BbIKTOP/M.2-key-M-to-wifi/copper_bottom_1200dpi.png

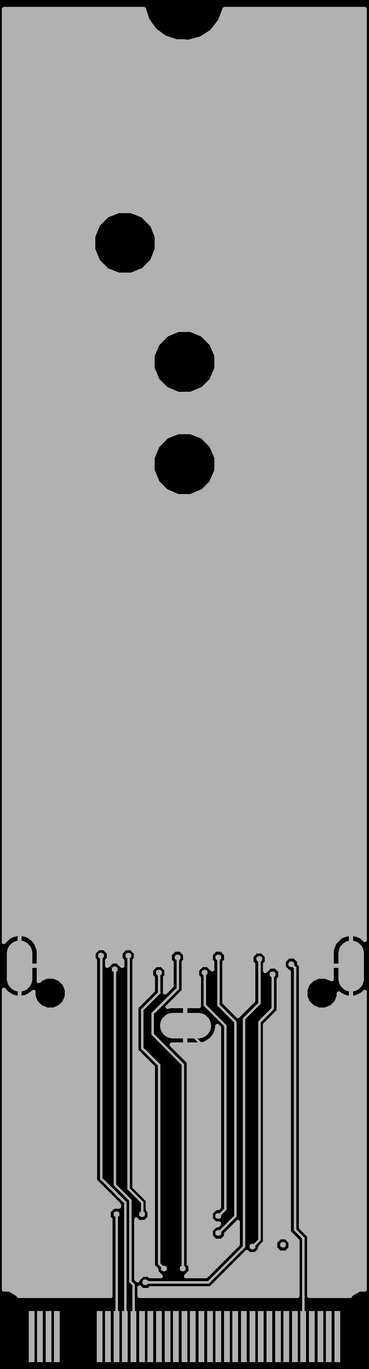
copper_bottom_1200dpi.png
