BbIKTOP/M.2-key-M-to-wifi/copper_top_1200dpi.png

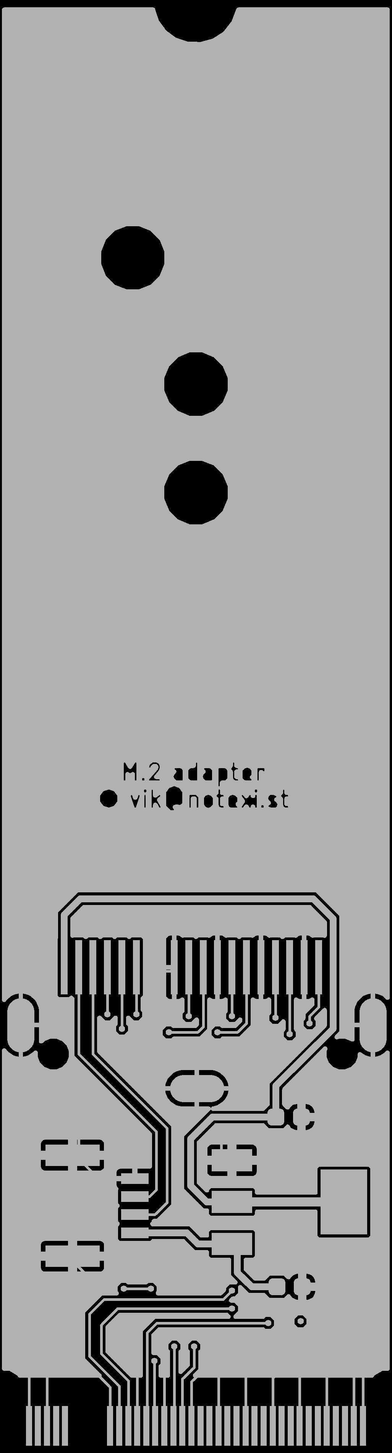
copper_top_1200dpi.png
