BbIKTOP/M.2-key-M-to-wifi/pics/wifi1.png

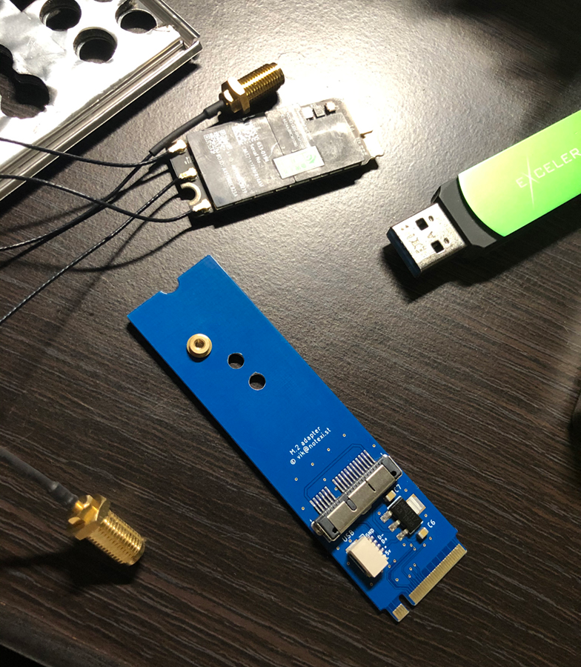
pics/wifi1.png
