BbIKTOP/M.2-key-M-to-wifi/pics/wifi2.png

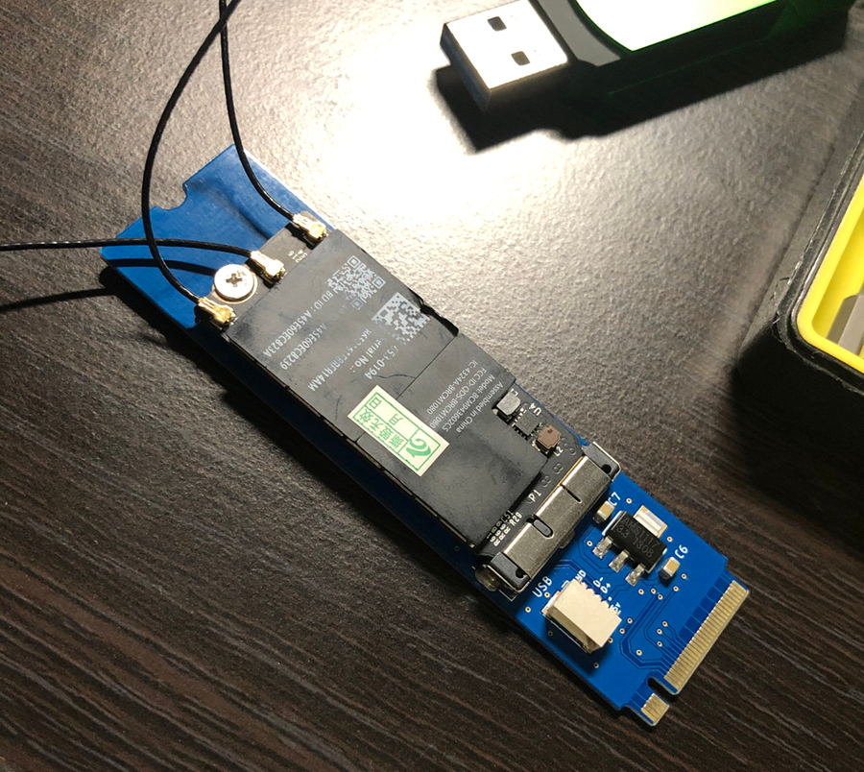
pics/wifi2.png
