BbIKTOP/M.2-key-M-to-wifi/pics/wifi3.png

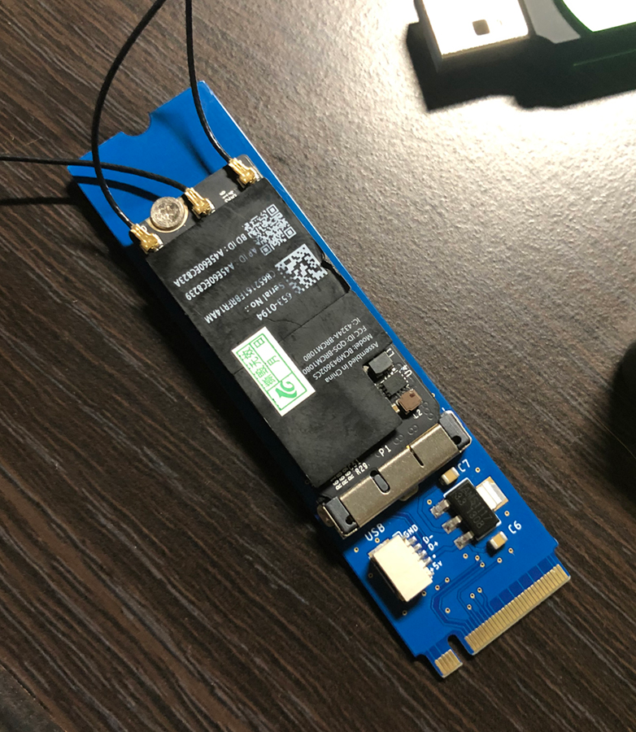
pics/wifi3.png
