BbIKTOP/M.2-key-M-to-wifi/pics/wifi4.png

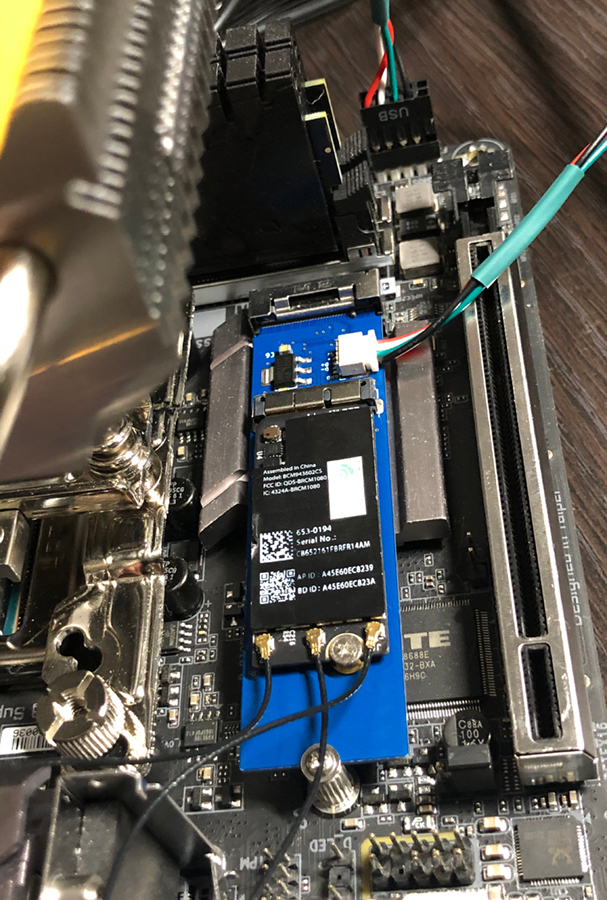
pics/wifi4.png
