BbIKTOP/M.2-key-M-to-wifi/m2_to_apple.sch

## EAGLE design m2_to_apple.sch (2020-07-29)

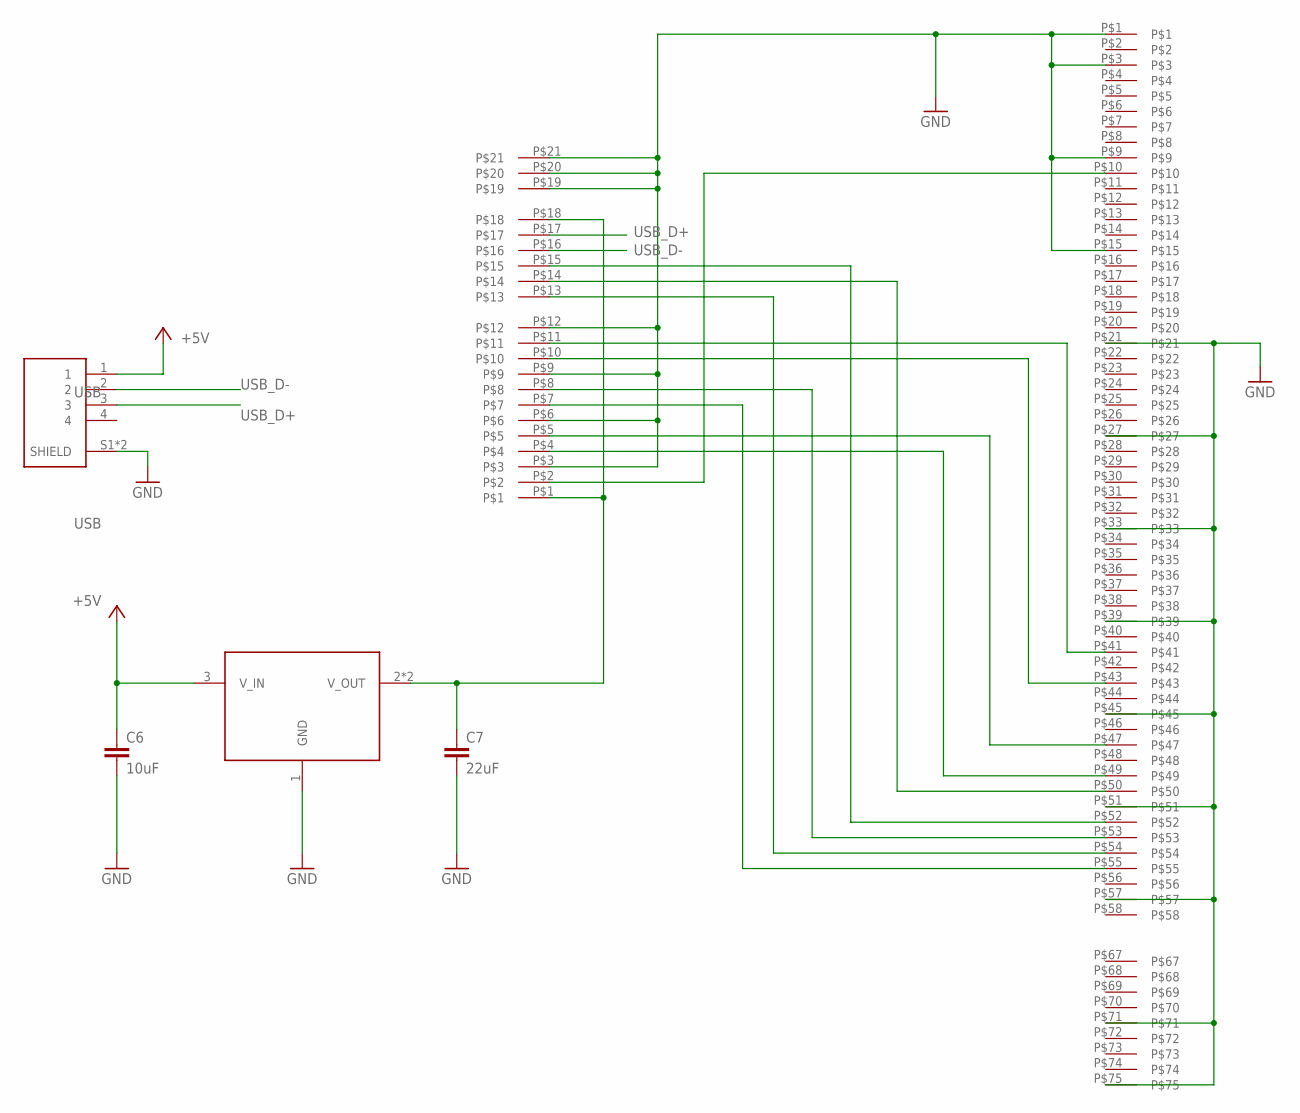
[picture p8: schematic m2_to_apple.sch]

Parts:
C6: 10uF; CAP_0603
C7: 22uF; CAP_0603
U$1: APPLE-WIFI; APPLE_WIFI
U$2: M.2_KEY_MSMD; M.2_KEY_M
U$3: LM1117; SOT223
USB: USB; JST_1MM_4PINS

Connections:
3V3: C7.1, U$1.P$1, U$1.P$18, U$3.2 (V_OUT)
+5V: C6.1, U$3.3 (V_IN), USB.1
CLKREQ#: U$1.P$15, U$2.P$52
GND: C6.2, C7.2, U$1.P$3, U$1.P$6, U$1.P$9, U$1.P$12, U$1.P$19, U$1.P$20, U$1.P$21, U$2.P$1, U$2.P$3, U$2.P$9, U$2.P$15, U$2.P$21, U$2.P$27, U$2.P$33, U$2.P$39, U$2.P$45, U$2.P$51, U$2.P$57, U$2.P$71, U$2.P$75, U$3.1 (GND), USB.S1 (SHIELD)
PER+0: U$1.P$10, U$2.P$43
PER-0: U$1.P$11, U$2.P$41
PERST#: U$1.P$14, U$2.P$50
PET+0: U$1.P$4, U$2.P$49
PET-0: U$1.P$5, U$2.P$47
PEWAKE#: U$1.P$13, U$2.P$54
REFCLK+: U$1.P$7, U$2.P$55
REFCLK-: U$1.P$8, U$2.P$53
USB_D+: U$1.P$17, USB.3
USB_D-: U$1.P$16, USB.2
WLAN_LED: U$1.P$2, U$2.P$10
